DannyDuckschDev/robotdog/(commit log)

2026-10-11 Add README, jaw servo test and calibration sheet
2026-10-11 Add browser bench: pin-control firmware, Web Serial page and scripts
    firmware/bench takes text commands (HIGH, LOW, PWM, READ, AREAD, STOP)
    over serial at 115200. bench/index.html shows a clickable Uno pinout,
    per-pin controls, wiring labels and a terminal, using Web Serial in
    Chrome. flash.sh uploads the firmware, bench.sh serves the page.
2026-10-11 Add jaw cycle test, bench screenshot, and sketch argument for flash.sh
    tests/jaw_cycle opens and closes the jaw between CLOSED_ANGLE and
    OPEN_ANGLE a set number of times at a controlled speed. flash.sh now
    takes a sketch folder, defaulting to the bench firmware. The README
    shows the bench connected with pin 9 labelled as the jaw servo.
2026-10-11 Add servo control and wiring drawing to the bench, plus a photo setup guide
    The bench firmware gets SERVO (jump or stepped move, reports AT when it
    arrives) and DETACH. The page now draws the Uno, breadboard and servos
    from bench/wiring.json with the real wire colours, and lets you add and
    edit parts, test a servo with a slider, closed/open buttons and a
    cycle, and save the angles back. bench/server.py serves the page and
    writes wiring.json.
    docs/setup-guide.md records how the jaw servo was wired, with the bench
    photos, the mistakes on the way, and the steps for the next servo.
    [bench.ino]
2026-10-12 Neck pitch servo on pin 3, row 9; remove roll for now
2026-11-02 Left eye servo on pin 6, row 15, with eye sweep test
    - tests/eyes/eye_sweep: sweeps the eye left and right around a center
    (80°, ±25°). Enter sweeps again, a number sets a new center, r releases
    the servo so the gears can be turned by hand.
    - Bench wiring: left eye wired on pin 6, breadboard row 15, end angles
    55° and 105°. The planned right eye moves to pin 5.
    - docs/build-log.md: log of the build steps so far and why.
2026-11-03 Right eye sweep test on pin 5, and fix pins in the docs
    - tests/eyes/eye_sweep_right: same sweep as the left eye, on pin 5,
    with a MIRRORED switch so both eyes look the same way first when
    the servos are mounted mirror-image. Center 80 is a starting guess.
    - docs/calibration.md: pitch on pin 3, roll not used, left eye on
    pin 6 (55-105, center 80), right eye on pin 5.
    - README.md: same pin fixes, and the eyes tests in the repo layout.
    [eye_sweep_right.ino]
2026-11-03 Right eye wired on pin 5, row 19; per-side ranges for both eyes
    - Both eye sketches have a separate range for each side
    (RANGE_BELOW, RANGE_ABOVE) and print the angle at each end.
    Shorter header comments.
    - Right eye: 45 below, 35 above the center (35 to 115), mirrored.
    Left eye unchanged at 55 to 105.
    - bench/wiring.json: right eye wired on row 19.
    - docs: calibration, README pin table, build log step 6 with the
    upload error from a loose USB cable.
    [eye_sweep.ino, eye_sweep_right.ino]
2026-11-03 Lower lip servo on pin 8, row 25 (not working yet)
    - tests/lower_lip/lower_lip_sweep: 20 degrees up and down around 90.
    The lip does not move yet.
    - The lower lip is fixed to the head with a screw and has more
    resistance than the other parts. Still to check whether an SG90 is
    strong enough or a stronger servo (e.g. MG90S) is needed.
    - bench/wiring.json, README, calibration: lower lip on pin 8; the
    planned left ear moves from pin 8 to pin 4.
    - Build log step 7, with the "Resource busy" upload error caused by
    the bench still holding the serial port.
    [lower_lip_sweep.ino]
2026-11-03 Note the stronger servo to test on the lower lip
2026-11-04 Neck base (yaw) test on pin 10, row 30, range 45-135; right ear moves to pin 2
2026-11-04 README status: eyes and lower lip tested, open issues #4 and #5, stronger servo as backup
